WeinstockIceCube/Cosmic-Muon-Test-Stand-Szintillator-Trigger/README.md

# Cosmic-Muon-Test-Stand-Szintillator-Trigger

This repository contains the Altium Projects (Altium Designer 20) for the electronics of the scintillator trigger system of the cosmic muon teststand at the Physics Institute 3B of the RWTH Aachen University.
