WeinstockIceCube/Cosmic-Muon-Test-Stand-Szintillator-Trigger/SiPM Carrier/DesignFiles/Report Board Stack/SiPM_Carrier_Board.xls

Board Stack Report
Stack Up |  | Layer Stack
Layer | Board Layer Stack | Name | Material | Thickness | Constant
1 |  | Top Paste
2 |  | Top Overlay
3 |  | Top Solder | Solder Resist | 0,39mil | 3,5
4 |  | Top Layer | Copper | 1,38mil
5 |  | Dielectric 1 | PP-006 | 5,51mil | 4,1
6 |  | GND | Copper | 1,38mil
7 |  | Dielectric1 | FR-4 | 47,24mil | 4,8
8 |  | Power | Copper | 1,38mil
9 |  | Dielectric 2 | PP-006 | 5,51mil | 4,1
10 |  | Bottom Layer | Copper | 1,38mil
11 |  | Bottom Solder | Solder Resist | 0,39mil | 3,5
12 |  | Bottom Overlay
13 |  | Bottom Paste
 | Height : 64,57mil
