WeinstockIceCube/Cosmic-Muon-Test-Stand-Szintillator-Trigger/Trigger Mainboard/DesignFiles/Report Board Stack/Trigger_Mainboard.xls

Board Stack Report
Stack Up |  | Layer Stack
Layer | Board Layer Stack | Name | Material | Thickness | Constant
1 |  | Top Paste
2 |  | Top Overlay
3 |  | Top Solder | Solder Resist | 0,40mil | 3,5
4 |  | Top Layer | Copper | 1,38mil
5 |  | Dielectric 3 | PP-006 | 5,51mil | 4,1
6 |  | GND1 | Copper | 1,38mil
7 |  | Dielectric 1 | PP-006 | 5,51mil | 4,1
8 |  | PWR1 | Copper | 1,38mil
9 |  | Dielectric1 | FR-4 | 35,83mil | 4,8
10 |  | PWR2 | Copper | 1,38mil
11 |  | Dielectric 2 | PP-006 | 5,51mil | 4,1
12 |  | GND2 | Copper | 1,38mil
13 |  | Dielectric 4 | PP-006 | 5,51mil | 4,1
14 |  | Bottom Layer | Copper | 1,38mil
15 |  | Bottom Solder | Solder Resist | 0,40mil | 3,5
16 |  | Bottom Overlay
17 |  | Bottom Paste
 | Height : 66,94mil
