WeinstockIceCube/Cosmic-Muon-Test-Stand-Szintillator-Trigger/SiPM Carrier/Documentation/PCBDrawing/Assembly Drawing.PDF

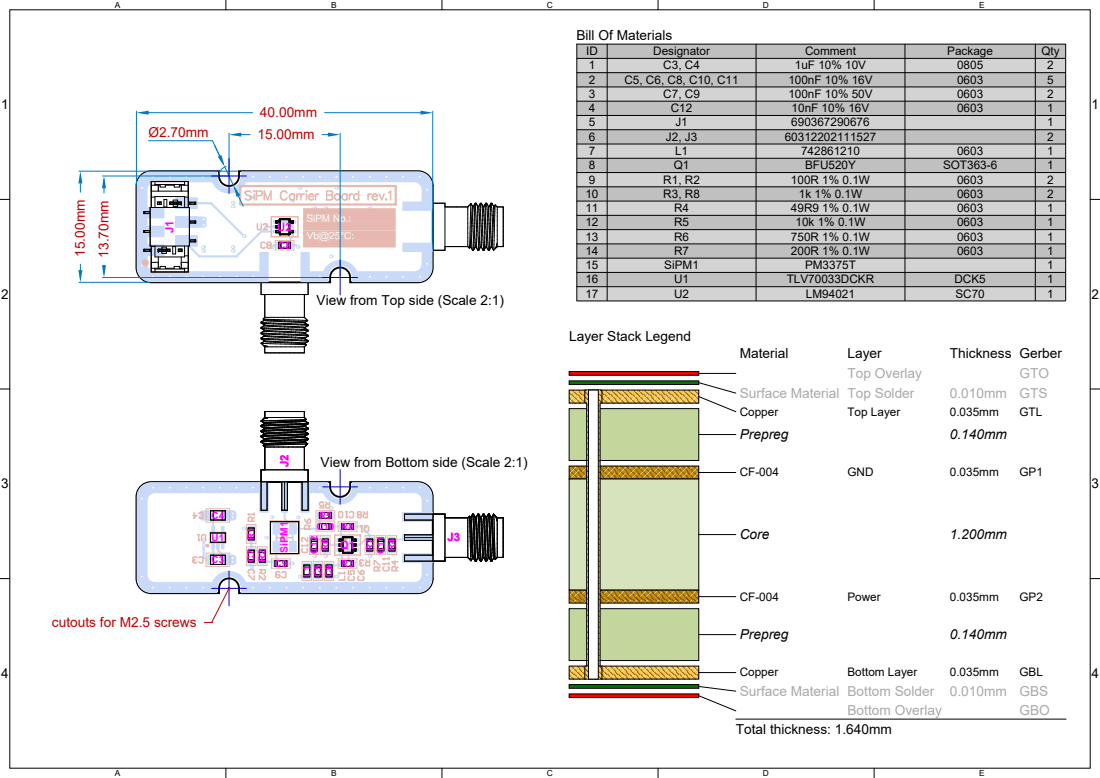
[picture p1: page 1]

View from Top side (Scale 2:1)

View from Bottom side (Scale 2:1)

Surface Material Bottom Solder 0.010mm GBS
