WeinstockIceCube/Cosmic-Muon-Test-Stand-Szintillator-Trigger/SiPM Carrier/Documentation/Schematic Print/Schematic Prints.PDF

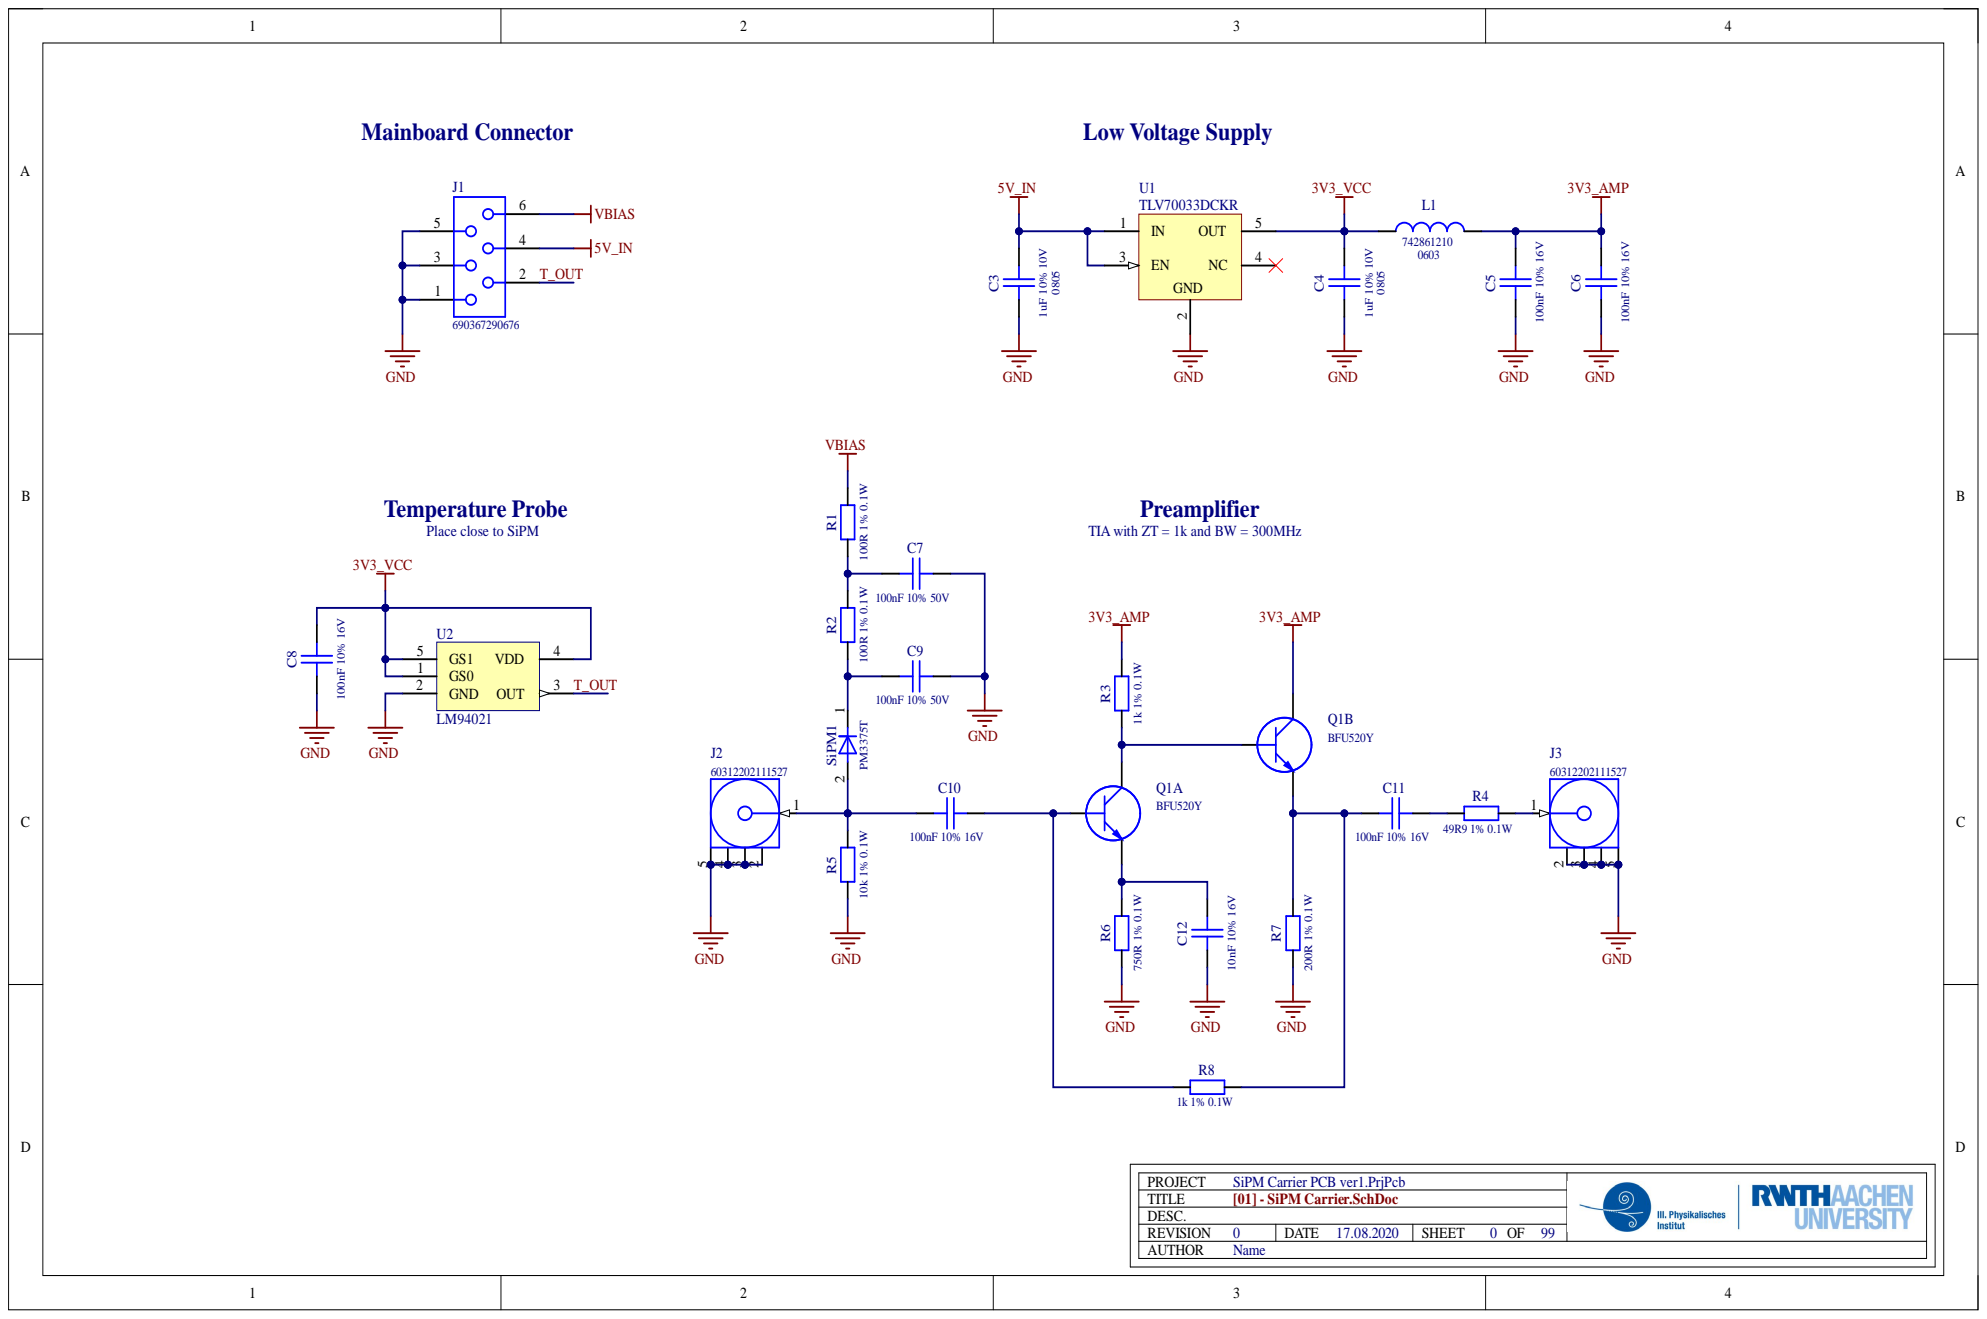
[picture p2: page 1]

Temperature Probe Place close to SiPM

Preamplifier TIA with ZT = 1k and BW = 300MHz
