WeinstockIceCube/Cosmic-Muon-Test-Stand-Szintillator-Trigger/Trigger Mainboard/Documentation/PCBDrawing/Assembly Drawing.PDF

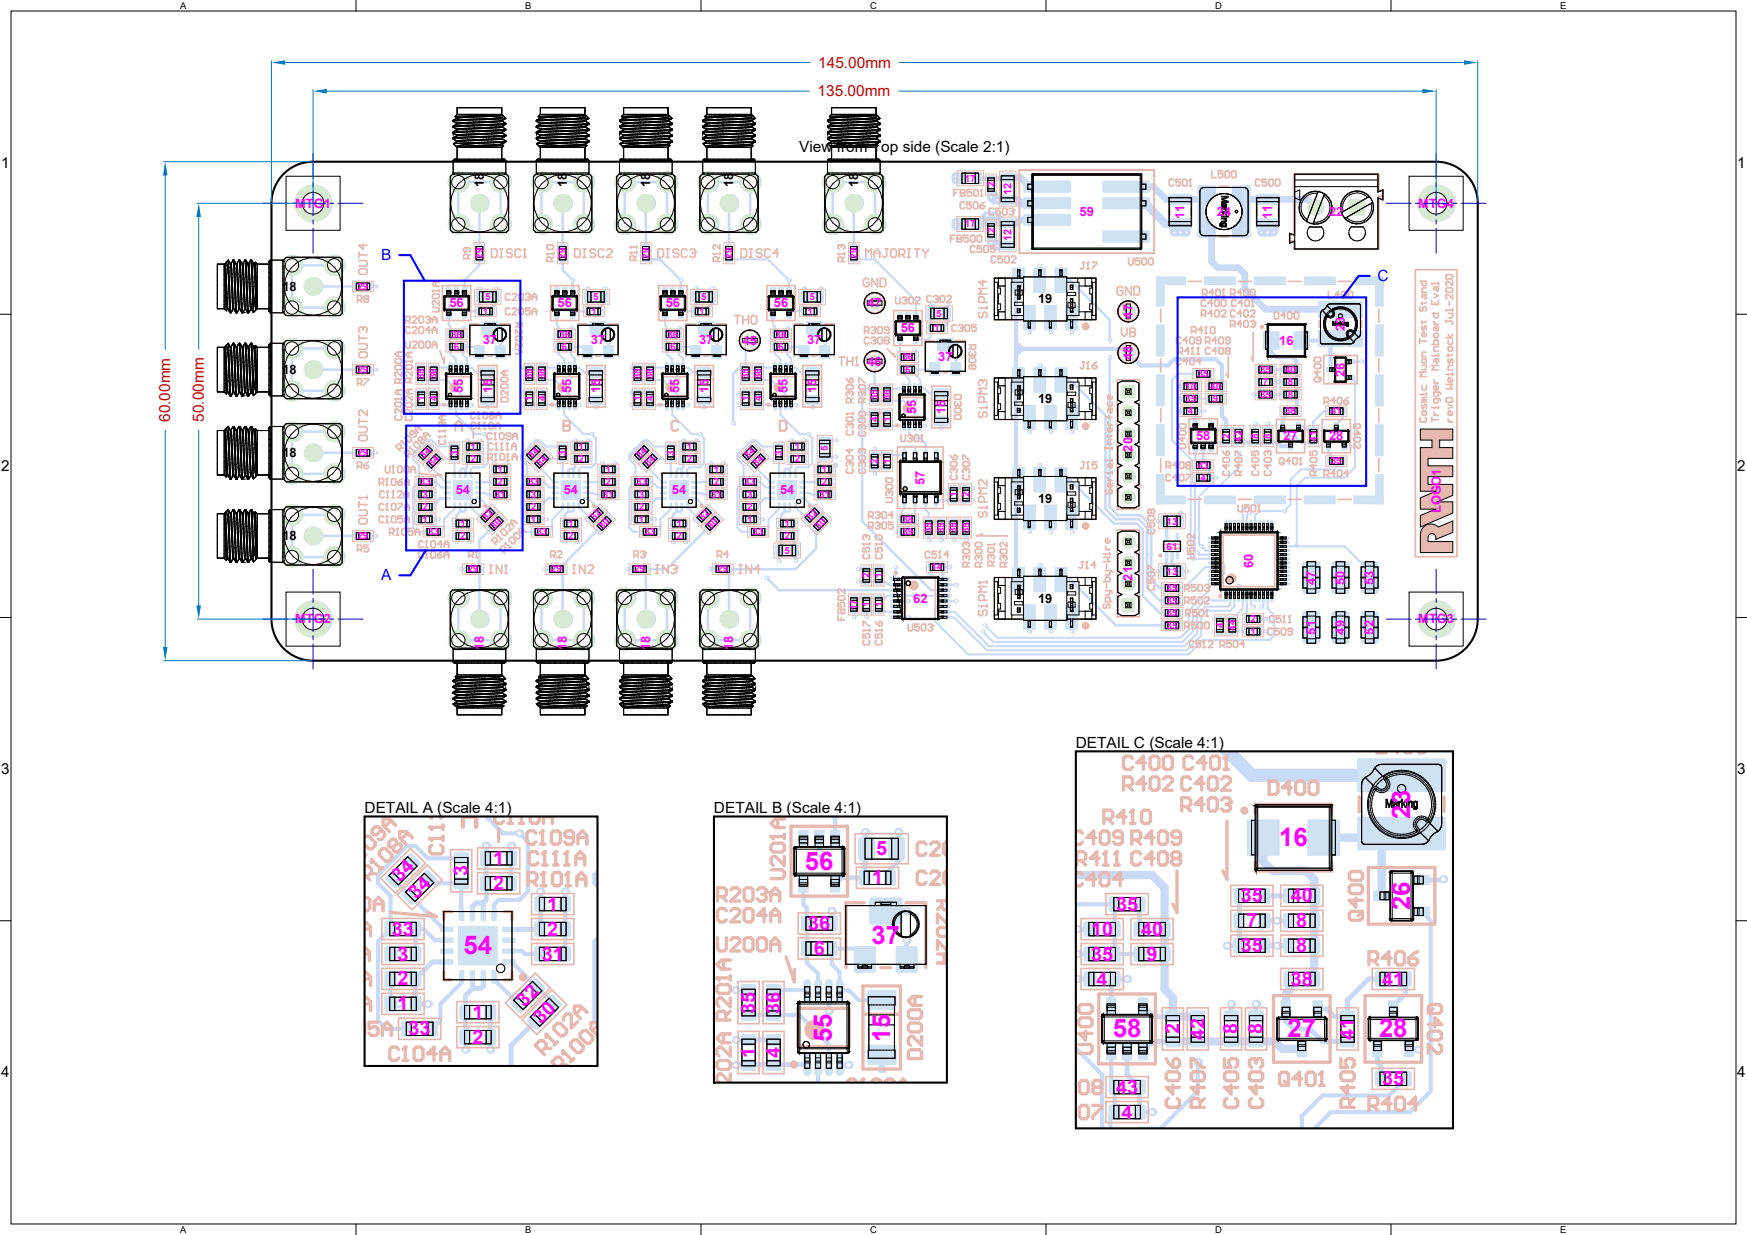
[picture p3: page 1]

View from Top side (Scale 2:1)

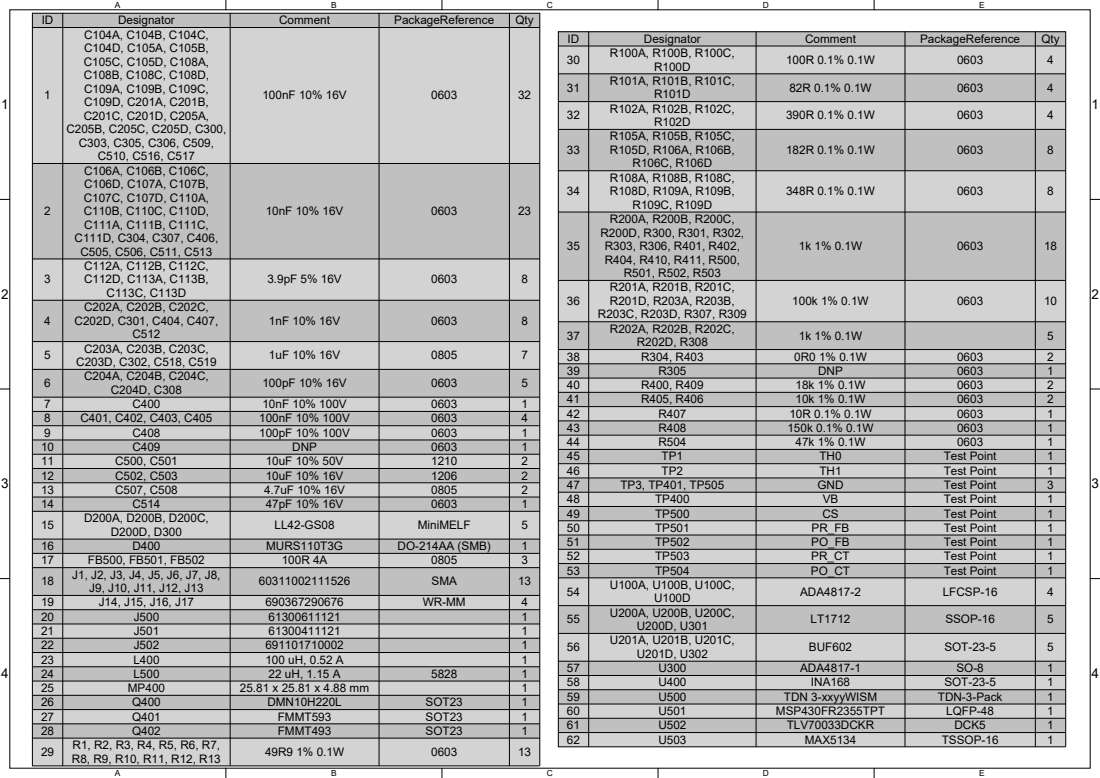
[picture p4: page 2]

Designator | Comment | PackageReference | Qty

31 | R101A, R101B, R101C, R101D | 82R 0.1% 0.1W | 0603 | Qty44488
ID | Designator | Comment | PackageReference
30 | R100A, R100B, R100C, R100D | 100R 0.1% 0.1W | 0603

36 | R201A, R201B, R201C, R201D, R203A, R203B, R203C, R203D, R307, R309 | 100k 1% 0.1W | 0603
44 | R504 | 47k 1% 0.1W | 0603 | 1052122111113111111455111111

38 | R304, R403 | 0R0 1% 0.1W | 0603
39 | R305 | DNP | 0603
40 | R400, R409 | 18k 1% 0.1W | 0603
41 | R405, R406 | 10k 1% 0.1W | 0603
42 | R407 | 10R 0.1% 0.1W | 0603
43 | R408 | 150k 0.1% 0.1W | 0603

10 | C409 | DNP | 0603
11 | C500, C501 | 10uF 10% 50V | 1210
12 | C502, C503 | 10uF 10% 16V | 1206
13 | C507, C508 | 4.7uF 10% 16V | 0805
14 | C514 | 47pF 10% 16V | 0603
15 | D200A, D200B, D200C, D200D, D300 | LL42-GS08 | MiniMELF

45 | TP1 | TH0 | Test Point
46 | TP2 | TH1 | Test Point
47 | TP3, TP401, TP505 | GND | Test Point
48 | TP400 | VB | Test Point
49 | TP500 | CS | Test Point
50 | TP501 | PR_FB | Test Point
51 | TP502 | PO_FB | Test Point
52 | TP503 | PR_CT | Test Point
53 | TP504 | PO_CT | Test Point
54 | U100A, U100B, U100C, U100D | ADA4817-2 | LFCSP-16

16 | D400 | MURS110T3G | DO-214AA (SMB)
17 | FB500, FB501, FB502 | 100R 4A | 0805
18 | J1, J2, J3, J4, J5, J6, J7, J8, J9, J10, J11, J12, J13 | 60311002111526 | SMA
21 | J501 | 61300411121 | | 134111111111
19 | J14, J15, J16, J17 | 690367290676 | WR-MM
20 | J500 | 61300611121

55 | U200A, U200B, U200C, U200D, U301 | LT1712 | SSOP-16

22 | J502 | 691101710002
23 | L400 | 100 uH, 0.52 A
24 | L500 | 22 uH, 1.15 A | 5828
25 | MP400 | 25.81 x 25.81 x 4.88 mm
26 | Q400 | DMN10H220L | SOT23
27 | Q401 | FMMT593 | SOT23
28 | Q402 | FMMT493 | SOT23
29 | R1, R2, R3, R4, R5, R6, R7, R8, R9, R10, R11, R12, R13 | 49R9 1% 0.1W | 0603 | 13

56 | U201A, U201B, U201C, U201D, U302 | BUF602 | SOT-23-5

57 | U300 | ADA4817-1 | SO-8
58 | U400 | INA168 | SOT-23-5
59 | U500 | TDN 3-xxyyWISM | TDN-3-Pack
60 | U501 | MSP430FR2355TPT | LQFP-48
61 | U502 | TLV70033DCKR | DCK5
62 | U503 | MAX5134 | TSSOP-16

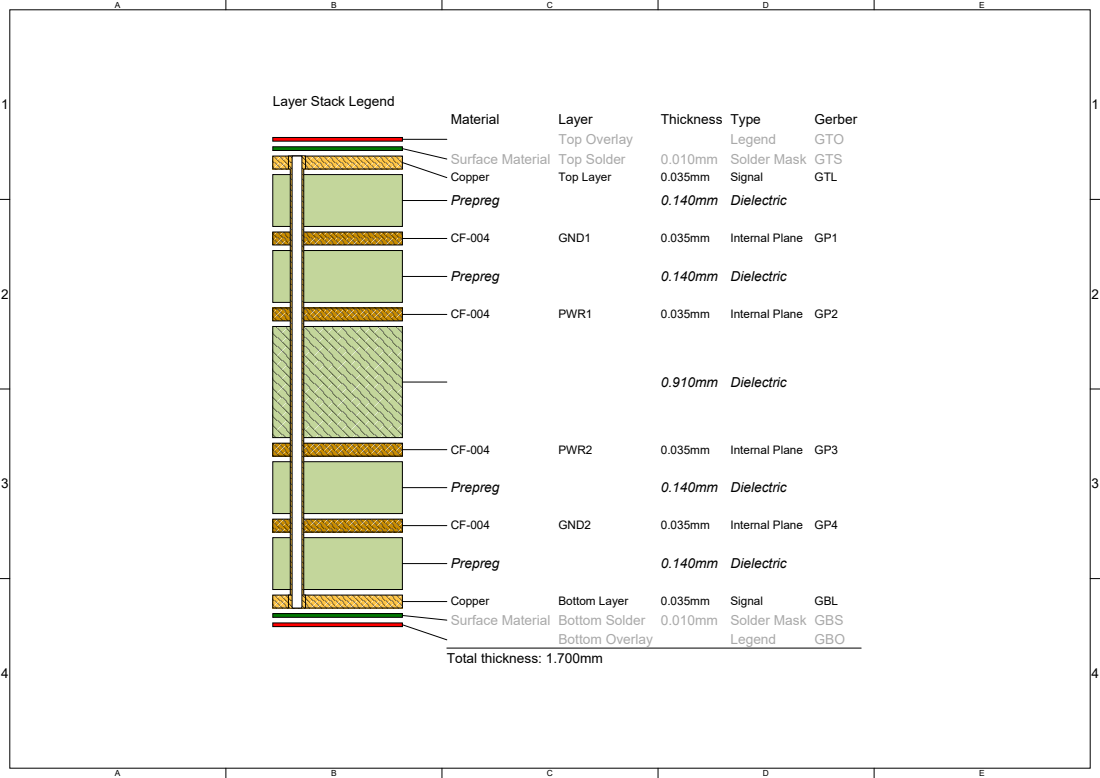
[picture p5: page 3]

Surface Material Bottom Solder 0.010mm Solder Mask GBS
