WeinstockIceCube/Cosmic-Muon-Test-Stand-Szintillator-Trigger/Trigger Mainboard/Documentation/Schematic Print/Schematic Prints.PDF

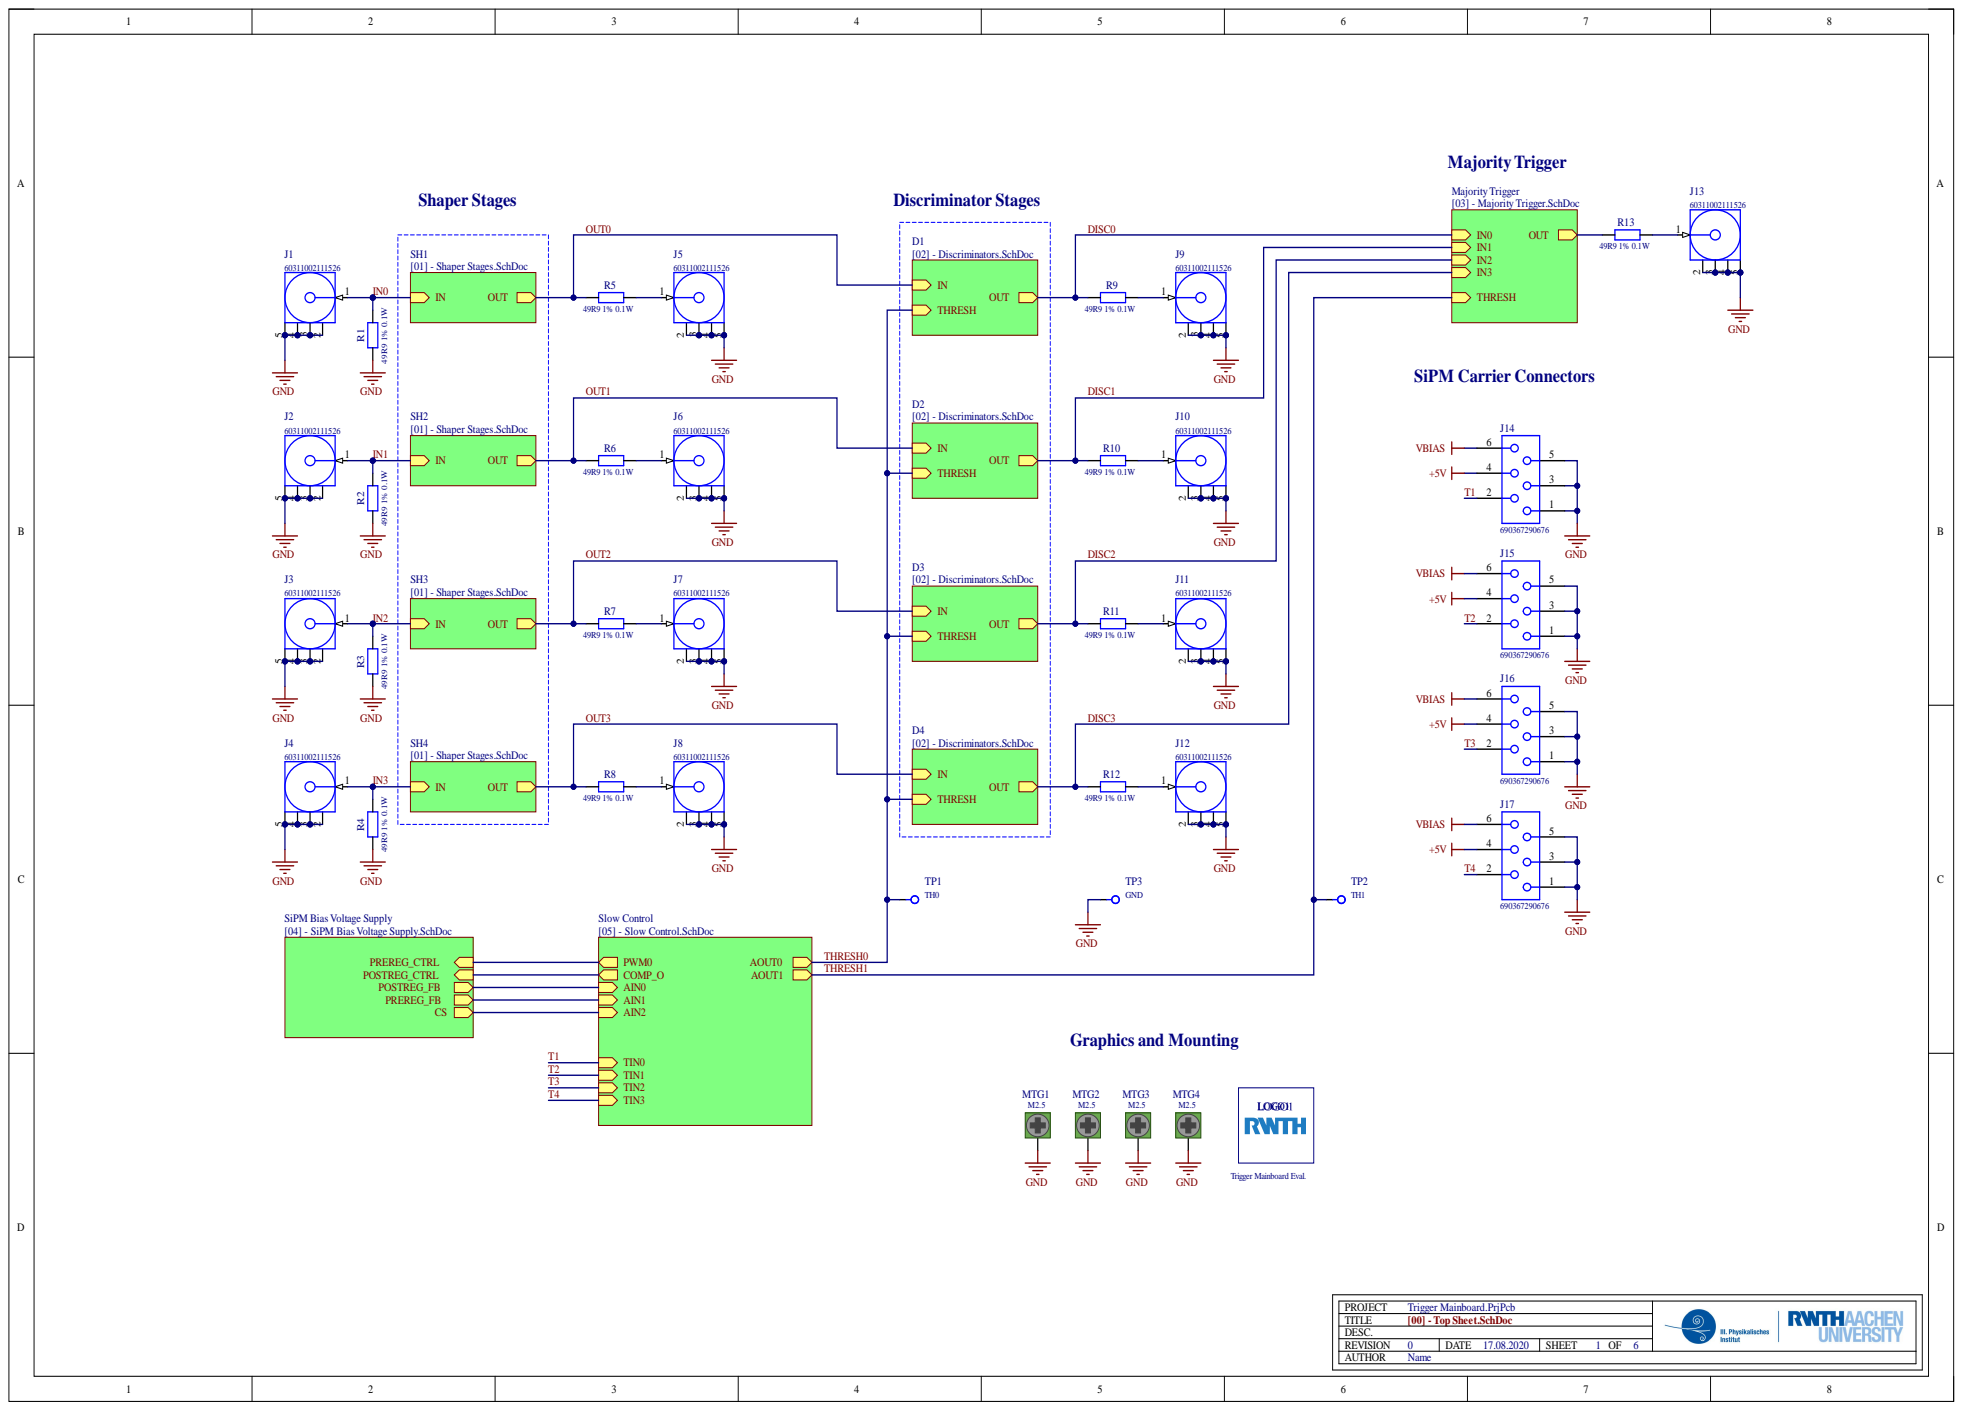
[picture p6: page 1]

49R9 1% 0.1W R8 | T H R ESH 0 | 49R9 1% 0.1W R12

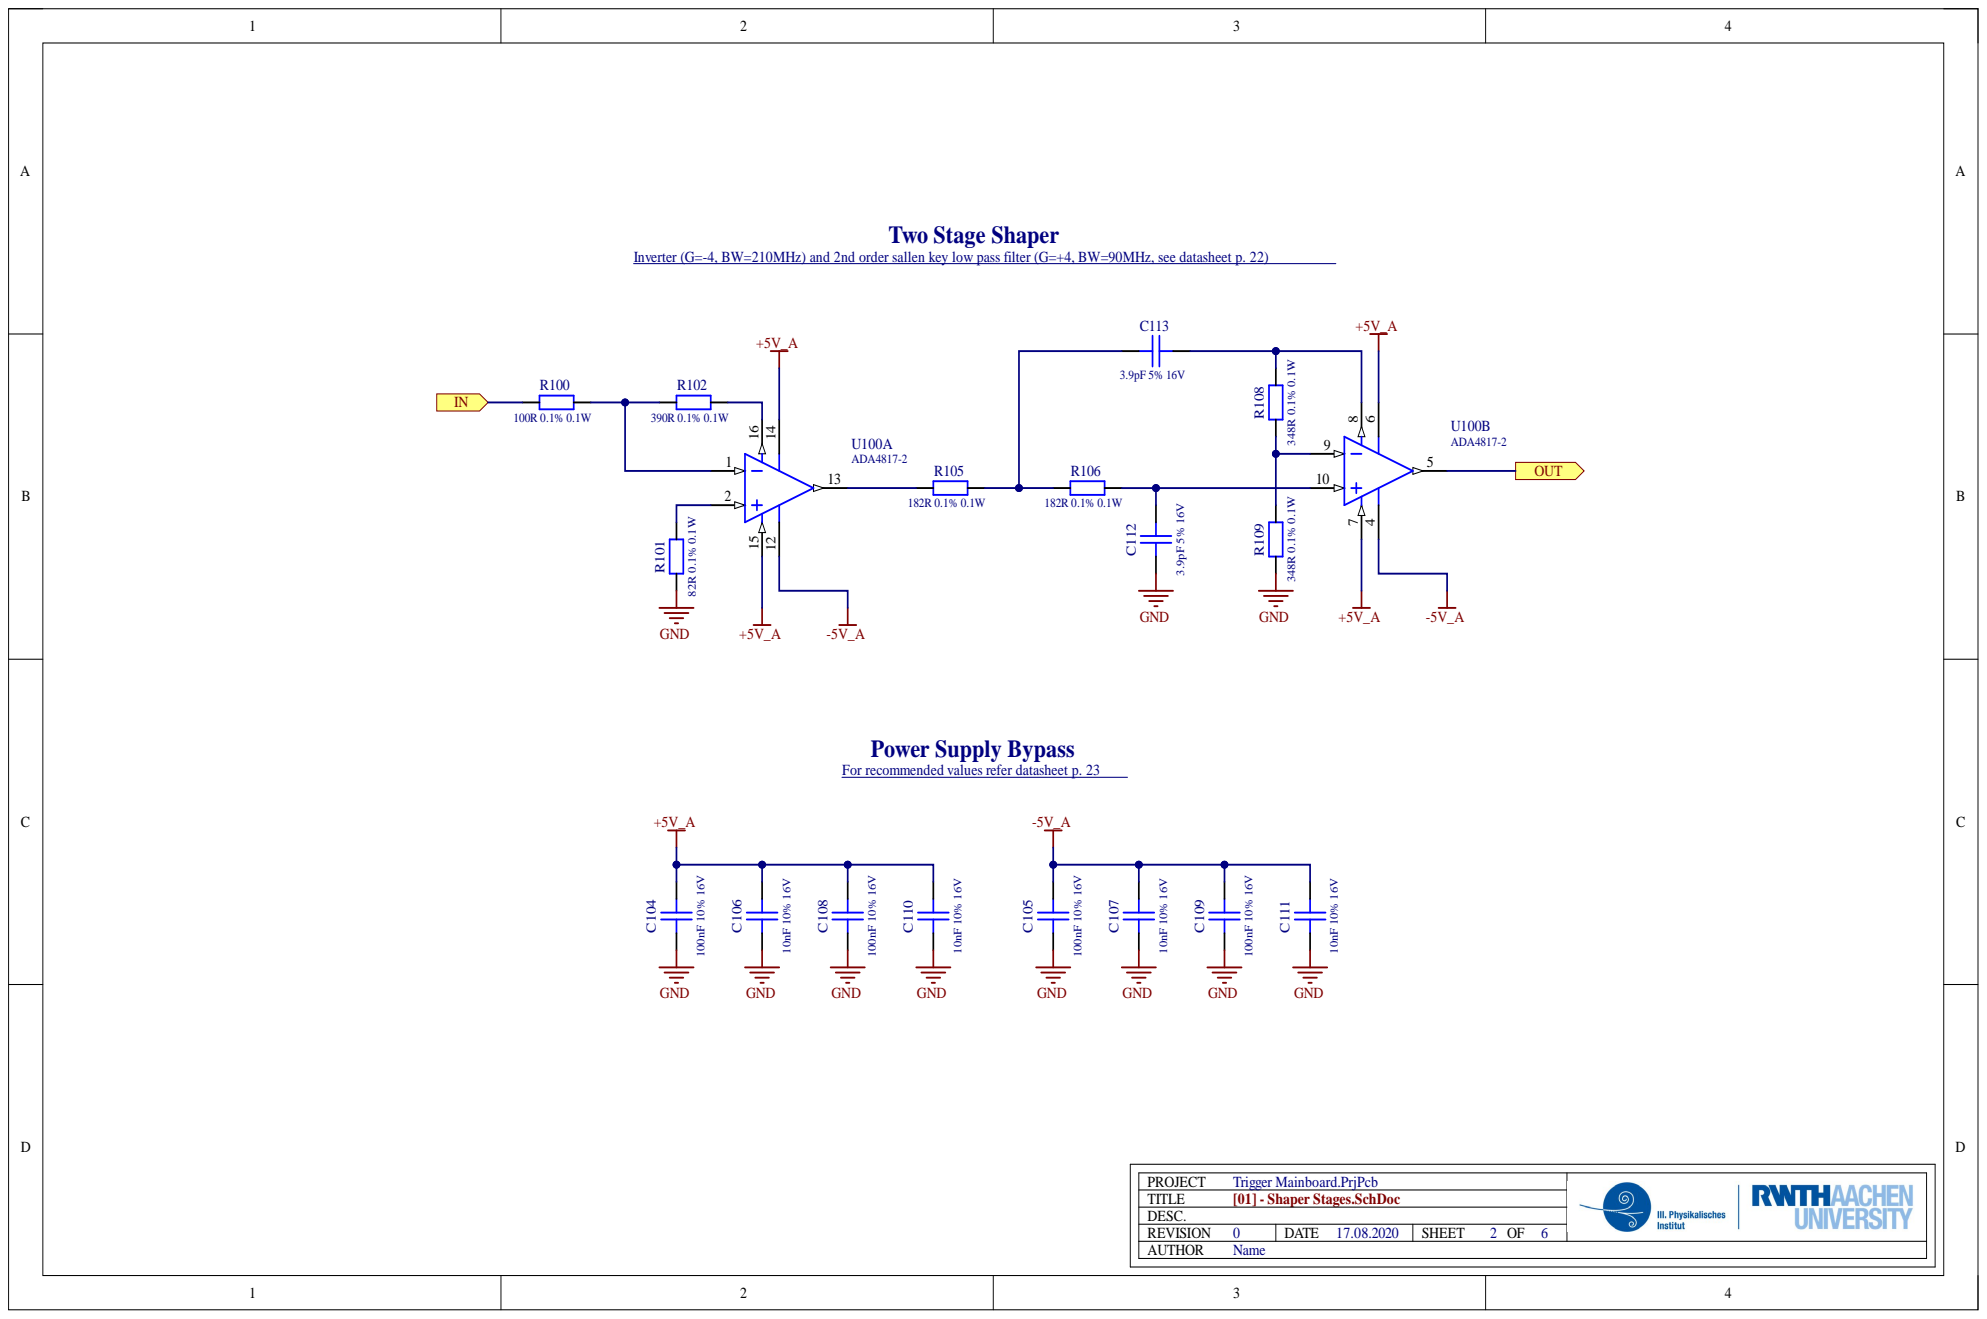
[picture p7: page 2]

Two Stage Shaper Inverter (G=-4, BW=210MHz) and 2nd order sallen key low pass filter (G=+4, BW=90MHz, see datasheet p. 22) (https://www.analog.com/media/en/technical-documentation/data-sheets/ADA4817-1_4817-2.pdf)

Power Supply Bypass For recommended values refer datasheet p. 23 (https://www.analog.com/media/en/technical-documentation/data-sheets/ADA4817-1_4817-2.pdf)

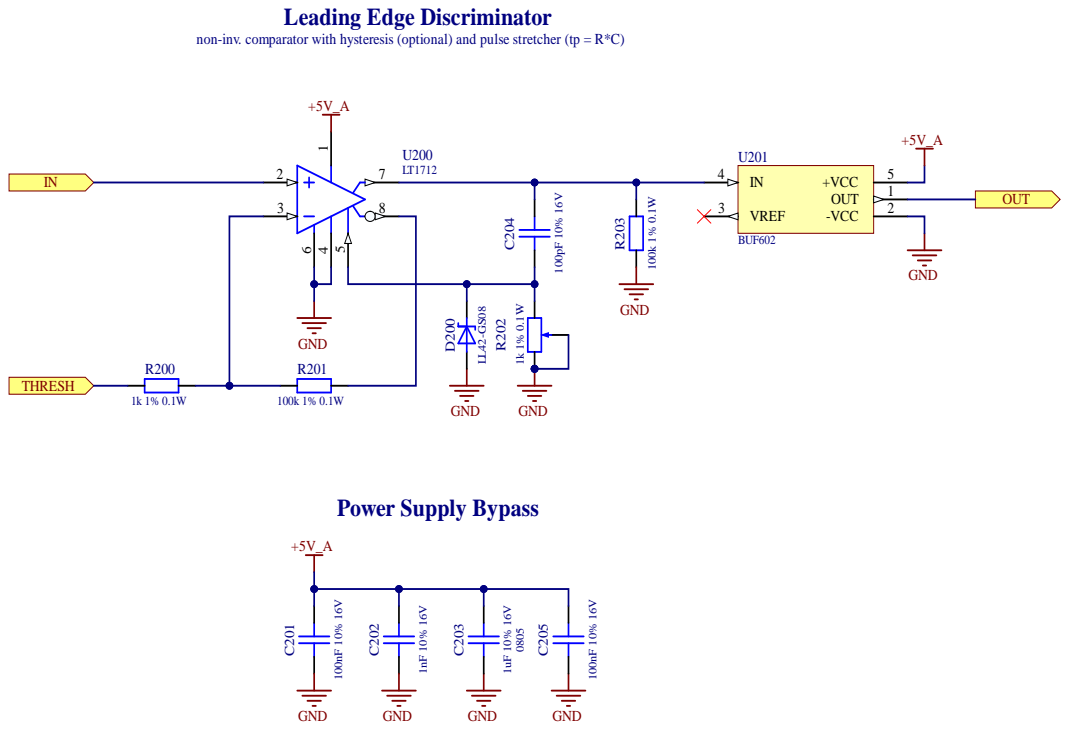
[picture p8: page 3]

Leading Edge Discriminator non-inv. comparator with hysteresis (optional) and pulse stretcher (tp = R*C)

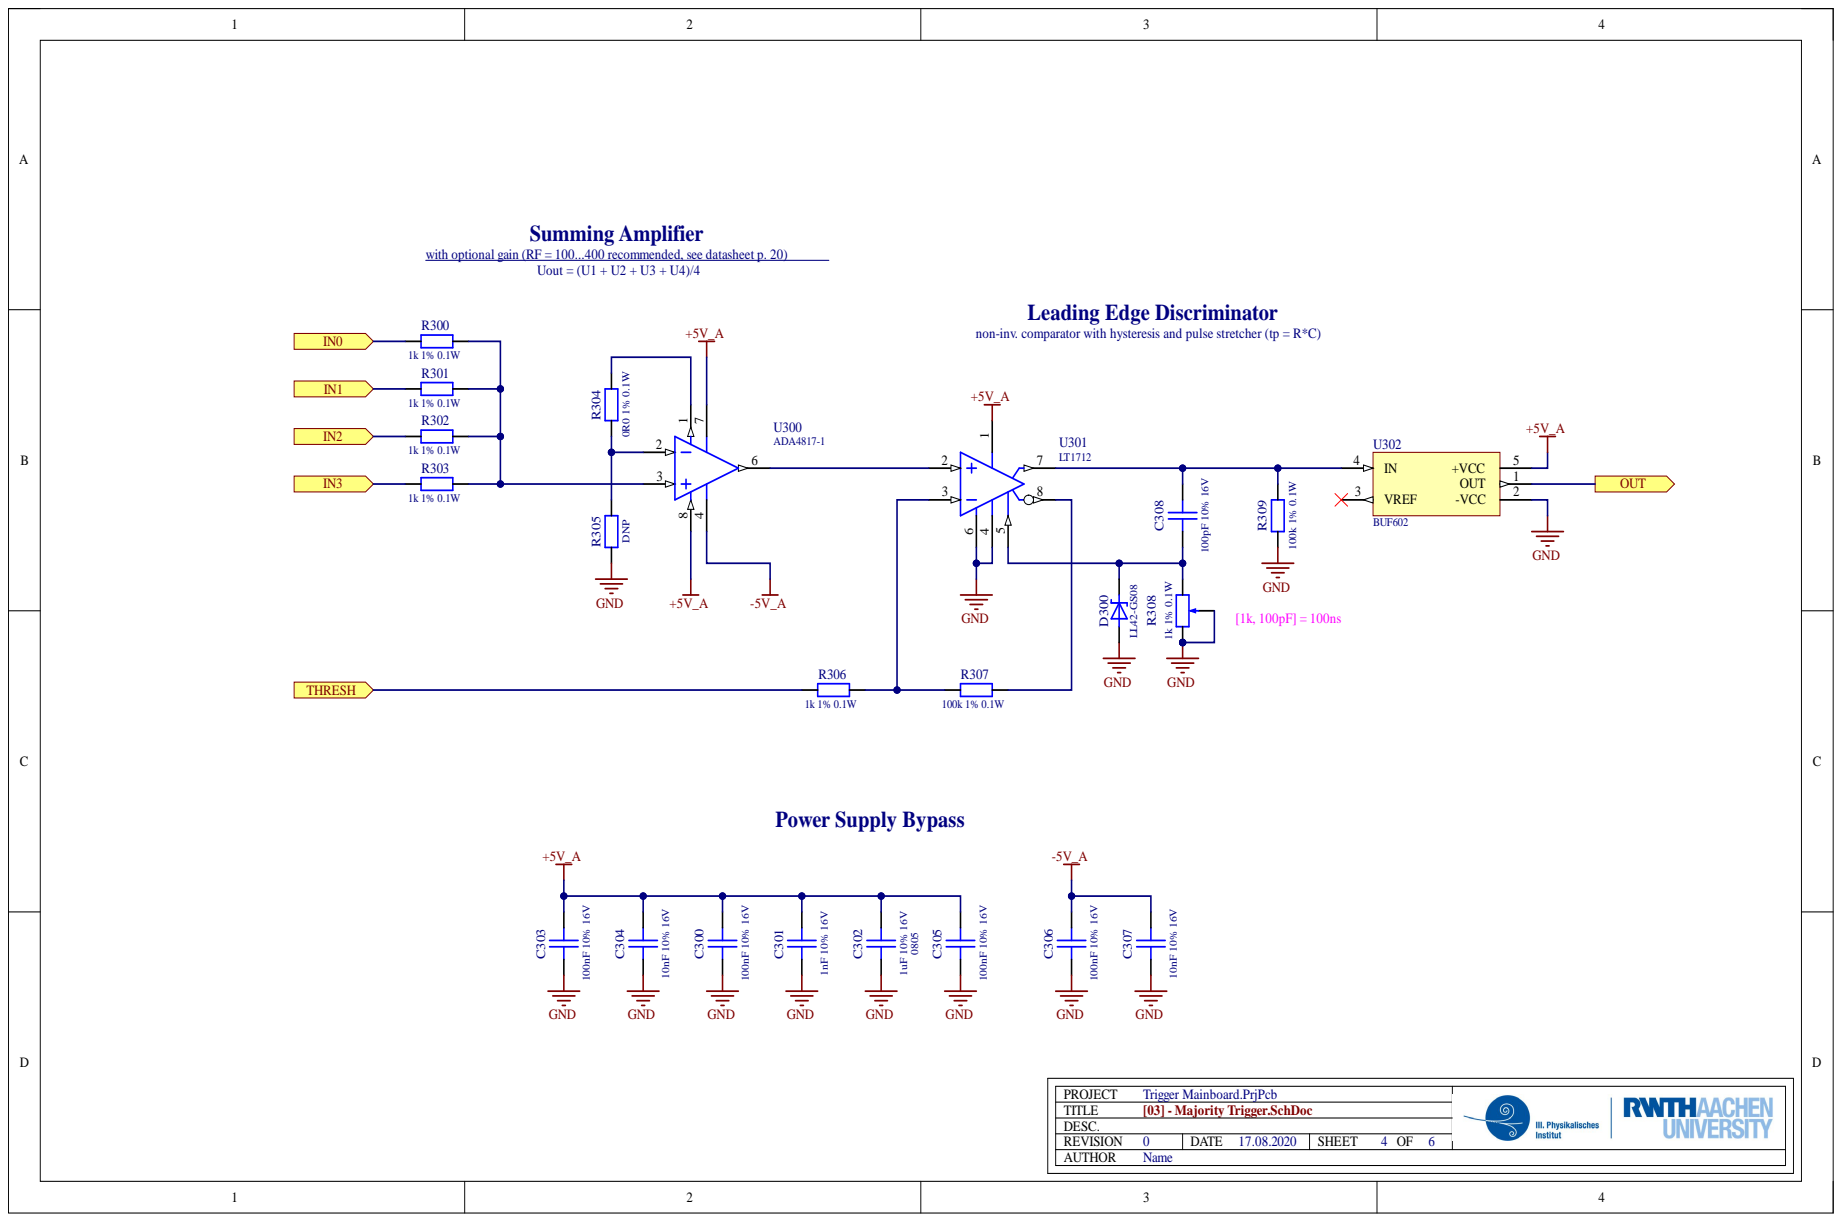
[picture p9: page 4]

Summing Amplifier with optional gain (RF = 100...400 recommended, see datasheet p. 20) (https://www.analog.com/media/en/technical-documentation/data-sheets/ADA4817-1_4817-2.pdf)

Leading Edge Discriminator non-inv. comparator with hysteresis and pulse stretcher (tp = R*C)

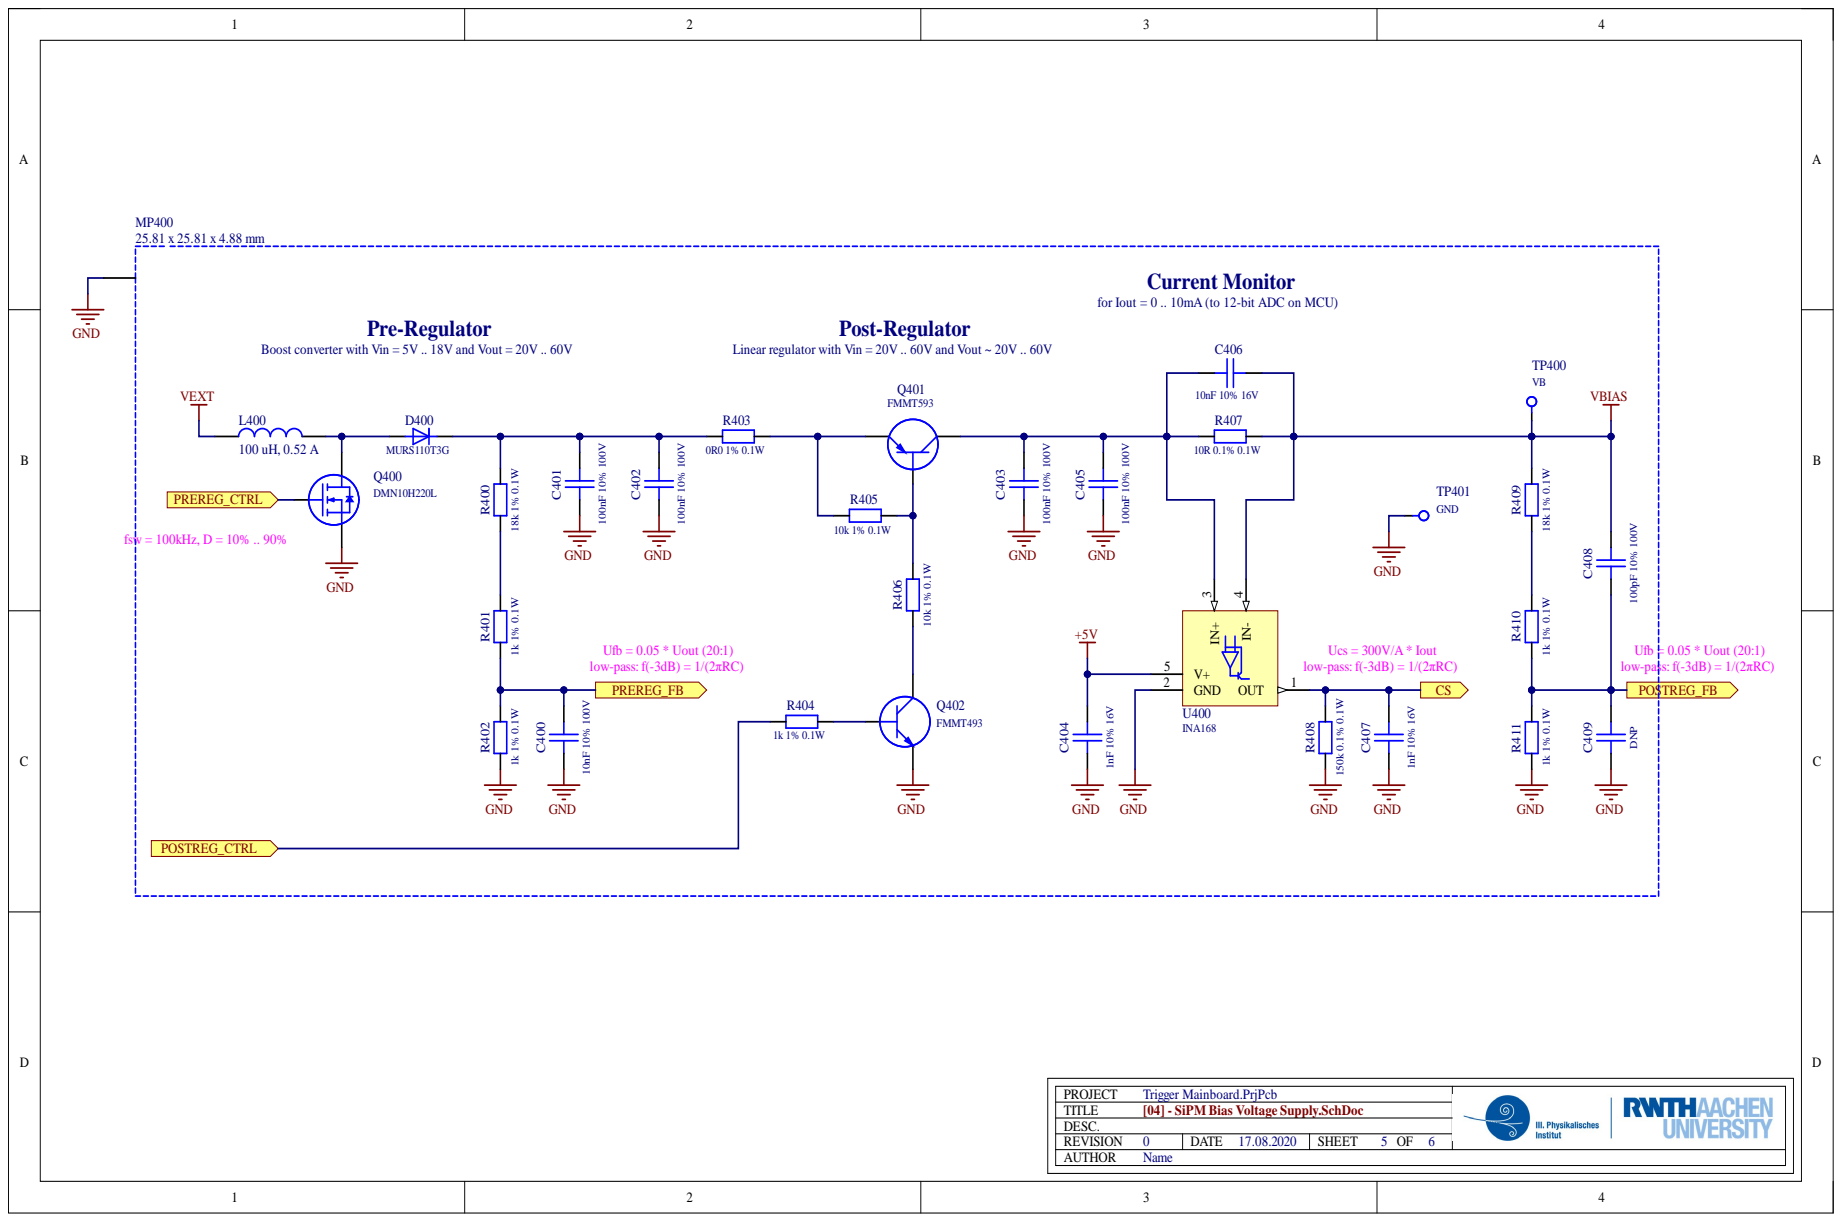
[picture p10: page 5]

for Iout = 0 .. 10mA (to 12-bit ADC on MCU)

Pre-Regulator Boost converter with Vin = 5V .. 18V and Vout = 20V .. 60V

Post-Regulator Linear regulator with Vin = 20V .. 60V and Vout ~ 20V .. 60V

[04] - SiPM Bias Voltage Supply.SchDoc

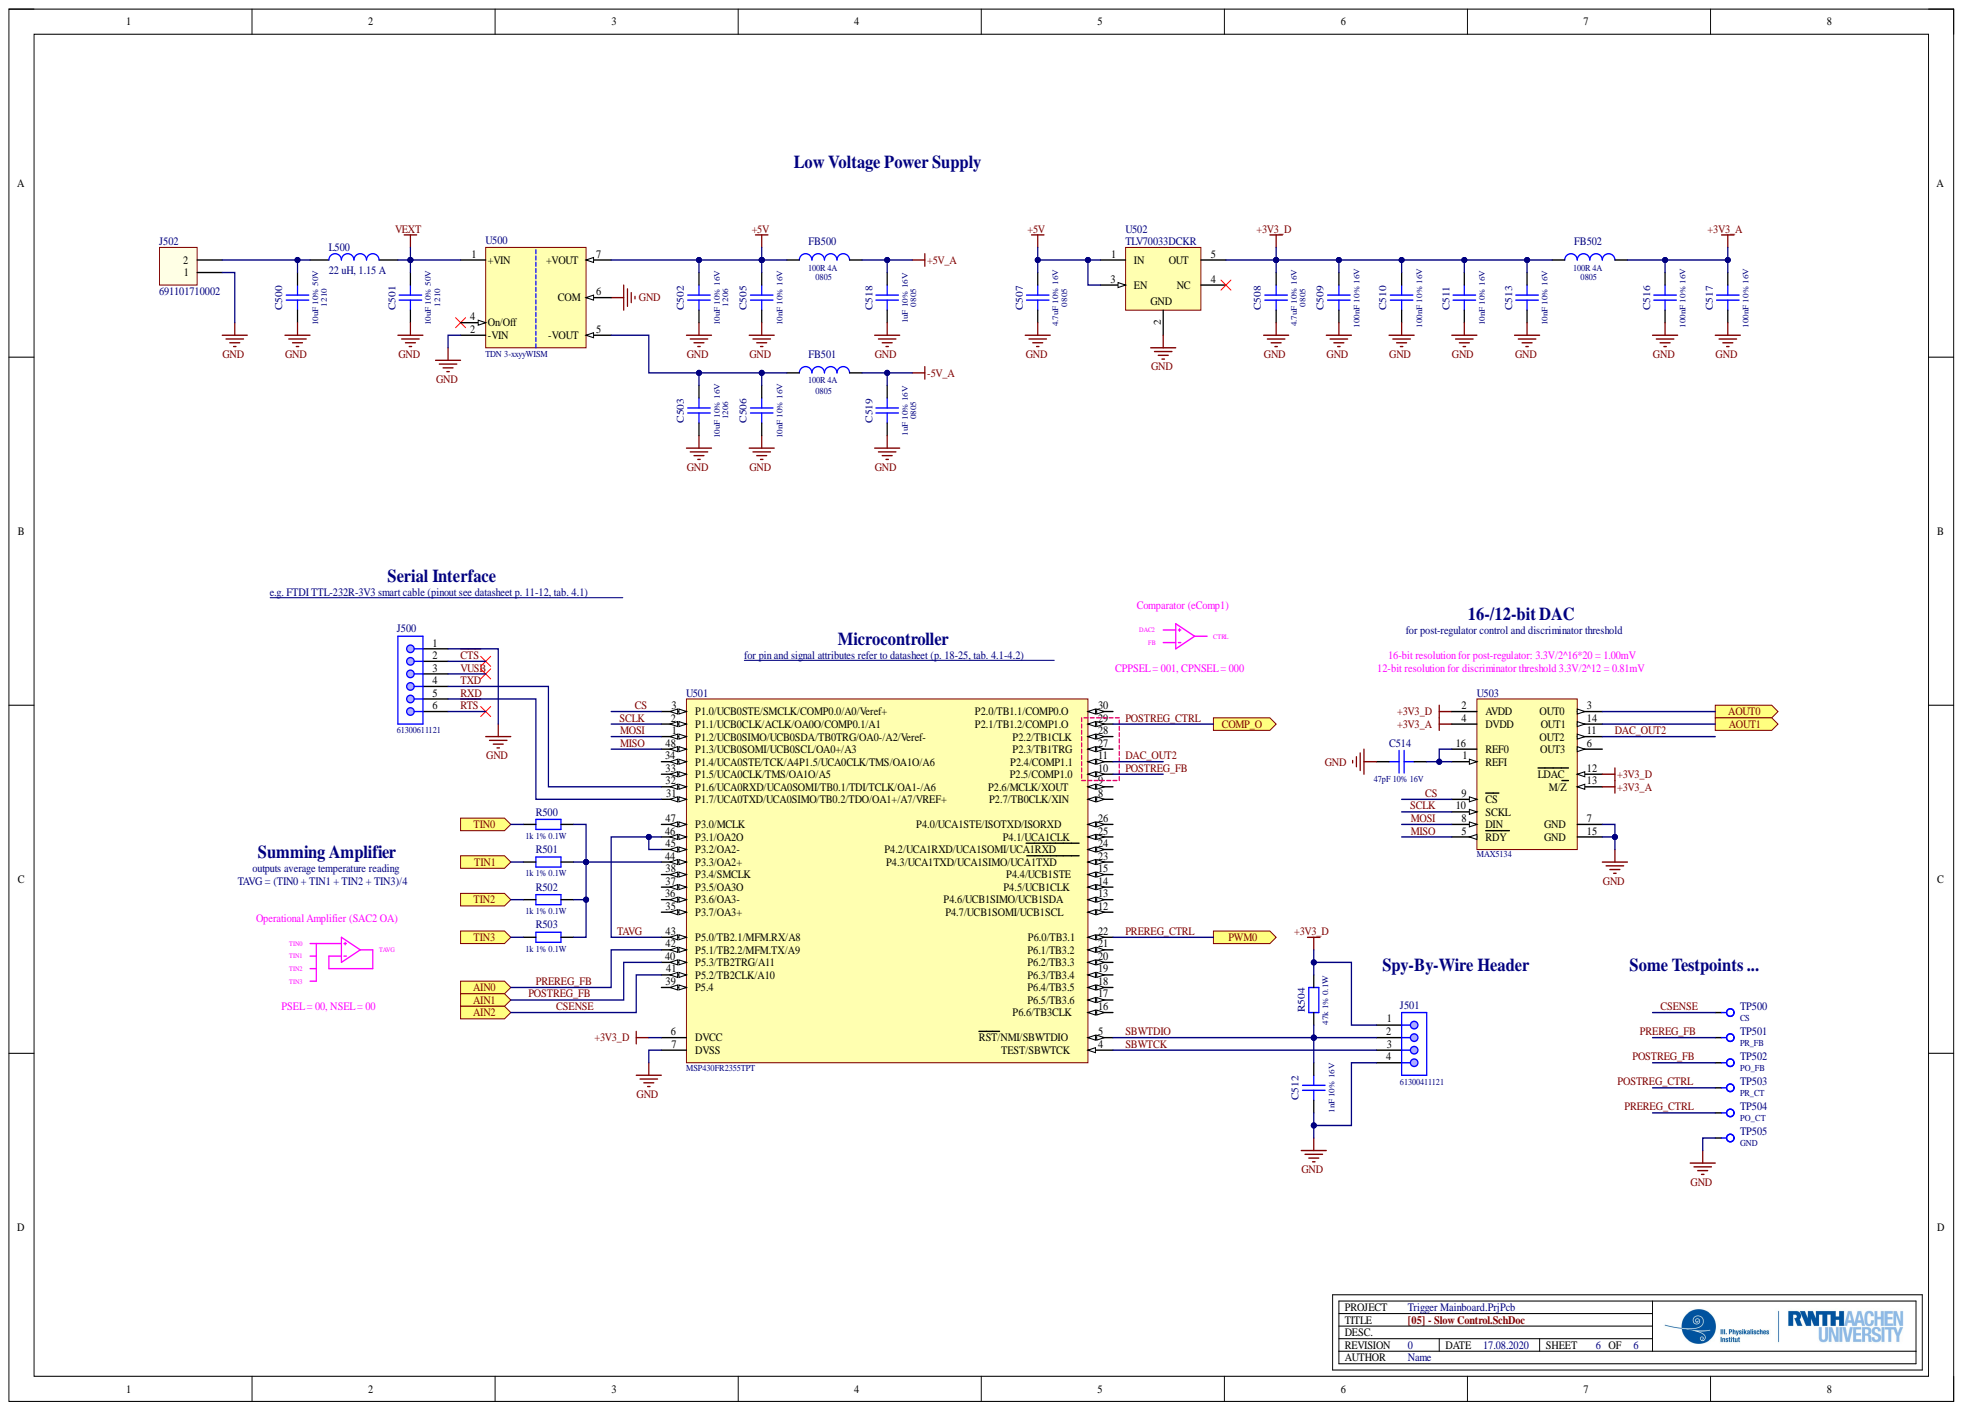
[picture p11: page 6]

Low Voltage Power Supply

Serial Interface e.g. FTDI TTL-232R-3V3 smart cable (pinout see datasheet p. 11-12, tab. 4.1) (https://www.ftdichip.com/Support/Documents/DataSheets/Cables/DS_TTL-232R_CABLES.pdf)

12-bit resolution for discriminator threshold 3.3V/2^12 = 0.81mV

Summing Amplifier outputs average temperature reading

P5.3/TB2TRG/A11 40
P5.2/TB2CLK/A10 41

Spy-By-Wire Header

PREREG_FB | P5.4 39
POSTREG_FB

DVSS 7 | SBWTCK | 3
