WeinstockIceCube/Cosmic-Muon-Test-Stand-Szintillator-Trigger/(list of files, drawings)

Other design files:
SiPM Carrier/[01] - SiPM Carrier.SchDoc
SiPM Carrier/SiPM Carrier PCB.PrjPcb
SiPM Carrier/SiPM_Carrier_Board.PcbDoc
Trigger Mainboard/[00] - Top Sheet.SchDoc
Trigger Mainboard/[01] - Shaper Stages.SchDoc
Trigger Mainboard/[02] - Discriminators.SchDoc
Trigger Mainboard/[03] - Majority Trigger.SchDoc
Trigger Mainboard/[04] - SiPM Bias Voltage Supply.SchDoc
Trigger Mainboard/[05] - Slow Control.SchDoc
Trigger Mainboard/Trigger Mainboard.PrjPcb
